rv5/tlahuilli/Tlahuilli-Circuit.pdf

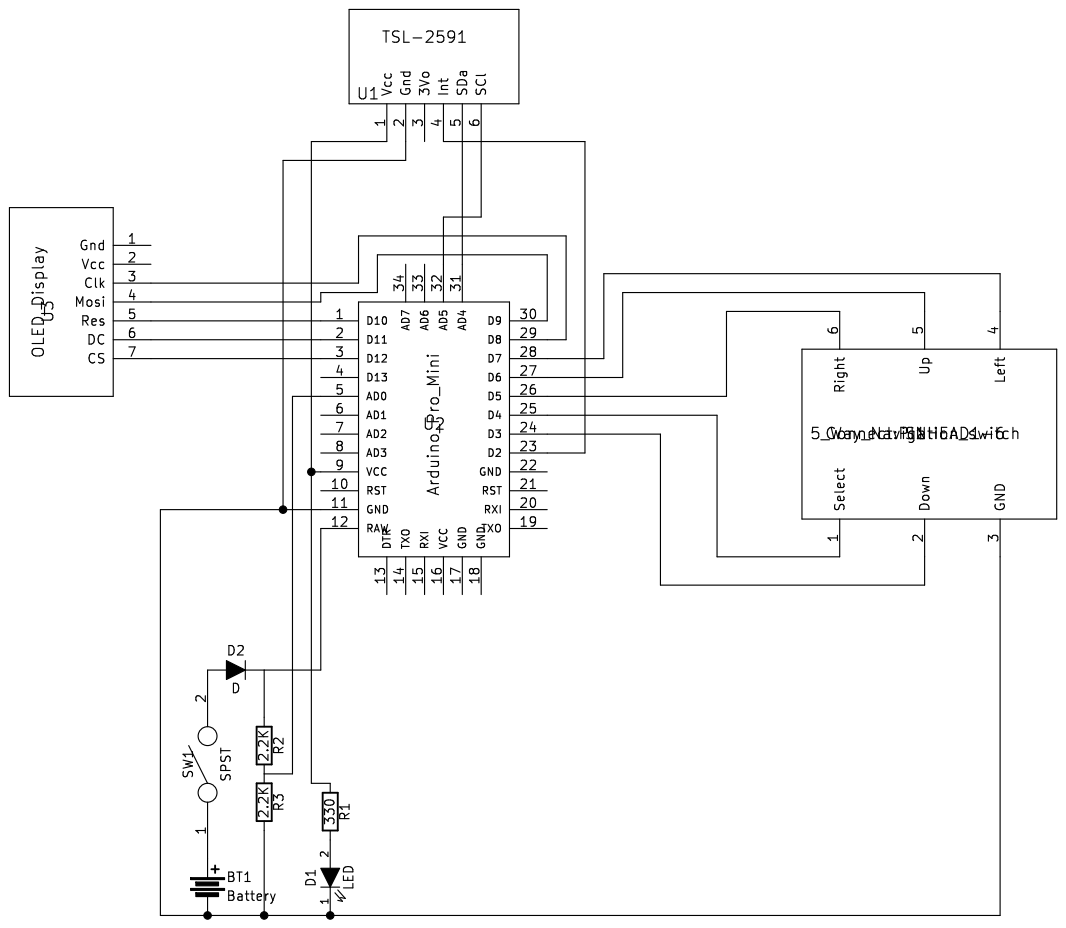
[picture p3: page 1]
